CastroGerman/IDCI/Project Outputs for MyPro/BOM.xls

Comment | Description | Designator | Footprint | LibRef | Quantity
100nF 16V Y5R | Capacitor | C1, C2, C4, C6, C8, C10, C12, C14, C16, C18, C23, C33 | C_0805 | Capacitor | 12
10nF 16V Y5R | Capacitor | C3, C5, C7, C9, C11, C13, C15, C17, C19 | C_0805 | Capacitor | 9
18pF 16V C0G | Capacitor | C20, C21 | C_0805 | Capacitor | 2
10uF 16V Y5R | Capacitor | C22, C31 | C_0805 | Capacitor | 2
0.1uF 50V 10% | Capacitor | C24 | C_0805 | Capacitor | 1
47pF 50V C0G | Capacitor | C25, C26 | C_0805 | Capacitor | 2
10nF 16V N7R | Capacitor | C27 | C_0805 | Capacitor | 1
4.7uF 6.3V X5R | Capacitor | C28 | C_0805 | Capacitor | 1
100nF 16V X7R | Capacitor | C29, C30 | C_0805 | Capacitor | 2
220uF 6.3V 20% |  | C32 | CT_2917_D | Polarized Capacitor | 1
27nF 16V Y5R | Capacitor | C34 | C_0805 | Capacitor | 1
330pF 16V C0G | Capacitor | C35 | C_0805 | Capacitor | 1
BAT60J | Generic Diode | D1, D2 | SOD323 | Diode | 2
JTAG Header |  | J1 | HDRM_2.54MM_1X8 | JTAG Header | 1
JTAG Header_1 |  | J2, J4, J5, J6, J7 | HDRM_2.54MM_1X8 | JTAG Header_1, Connector1x8 | 5
USB MICRO AB |  | J3 | USB_MICRO_F_AB | Connectorx6 | 1
Connector |  | J8 | HDRM_0.1_1X4 | Connectorx4 | 1
Power Supply |  | J9 | HDRM_0.1_1X2 | Power Connector | 1
Green | Green LED | L1 | LED_0805 | Led_G | 1
Red | Red LED | L2 | LED_0805 | Led_R | 1
8.2uH 20% | Inductor | L3 | 1R5_1710 | Inductor | 1
TBJ |  | Q1, Q2 | SOT-23 | TBJ_NPN | 2
10KΩ 1% | Resistor | R1, R2, R3, R4, R5 | R_0805 | Resistor | 5
10K 5% | Resistor | R6, R12 | R_0805 | Resistor | 2
1K 5% | Resistor | R7, R9 | R_0805 | Resistor | 2
27R 5% | Resistor | R8, R10 | R_0805 | Resistor | 2
12K 1% | Resistor | R11, R13 | R_0805 | Resistor | 2
15K 5% | Resistor | R14 | R_0805 | Resistor | 1
470R 5% | Resistor | R15, R16 | R_0805 | Resistor | 2
9.1KΩ 1% | Resistor | R17 | R_0805 | Resistor | 1
5.49KΩ 1% | Resistor | R18 | R_0805 | Resistor | 1
3.6KΩ 1% | Resistor | R19 | R_0805 | Resistor | 1
TestPoint |  | TP0 | TestPoint | TestPoint | 1
LPC1769 | 32 bit ARM Cortex M3 | U1 | LQFP100 | LPC1769 | 1
ESP32WROOM |  | U2 | ESP32_WROOM - DUPLICATE | ESP32WROOM | 1
FT231XS | FT231XS | U3 | SSOP_20 | FT231XS | 1
A5972D | Fuente Switching 3.3v 1.5A | U4 | SO_8 | A5972D | 1
ABM8W 12MHz | Crystal | Y1 | ABM8W | Crystal | 1
