CastroGerman/IDCI/(list of files, drawings)

Other design files:
ESP32WROOM.SchDoc
LPC1769.SchDoc
MyPro.PcbDoc
MyPro.PcbLib
MyPro.PrjPCB
MyPro.SchLib
Panelizado.PcbDoc
Perifericos.SchDoc
