CastroGerman/IDCI/(commit log)

2019-07-16 No IPS, only JTAG
    Esquematico: Cableado de Uart's listo/r/n Cableado de GPIO's a la espera.
    [MyPro.PrjPCB, MyPro.SchLib, MyProSch1.SchDoc, MyProSch2.SchDoc, MyProSch3.SchDoc, MyProSch4.SchDoc, MyProSch5.SchDoc]
2019-07-19 Switching + Bridge Routing
    [MyPro.PcbDoc, MyPro.PcbLib, MyPro.PrjPCB, MyProSch1.SchDoc, MyProSch3.SchDoc, MyProSch4.SchDoc]
2019-07-19 Clean Branch
    [MyPro.PcbDoc, MyPro.PcbLib, MyPro.PrjPCB, MyPro.SchLib, MyProSch1.SchDoc, MyProSch3.SchDoc, MyProSch4.SchDoc]
2019-07-22 Primer routeo general
    NEW: LPC JTAG pull ups resistors. RTS & DTR pins on ISP Debug. SOT-23 footprint. LPC & ESP32 routing. DELETE: ESP JTAG serial resistors. PENDING: Power Lines routing (5v, 3.3v, GND). JTAG connectors routing. New components layout.
    [MyPro.PcbDoc, MyPro.PcbLib, MyPro.PrjPCB, MyPro.SchLib, MyProSch1.SchDoc, MyProSch3.SchDoc, MyProSch4.SchDoc]
2019-08-28 Board Update
    Nueva disposicion LPC JTAG y Switching
    [MyPro.PcbDoc, MyPro.PcbLib, MyPro.SchLib, MyProSch1.SchDoc, MyProSch3.SchDoc]
2019-09-06 Board Update: GPIOs routing
    [MyPro.PcbDoc]
2019-09-07 Commit de entrega (#5)
    [MyPro.PcbDoc, MyPro.PcbLib, MyPro.PrjPCB, MyPro.SchLib, MyProSch1.SchDoc, MyProSch3.SchDoc, MyProSch4.SchDoc]
2019-09-07 Commit entrega (#9)
    [MyPro.PcbDoc, MyPro.PrjPCB]
2019-09-15 Board Update
    Delete some Solder Masks
    [MyPro.PcbDoc, MyPro.PcbLib, MyPro.PrjPCB]
2019-09-23 Pre Entrega
    [ESP32WROOM.SchDoc, LPC1769.SchDoc, MyPro.PcbDoc, MyPro.PcbLib, MyPro.PrjPCB, MyProSch1.SchDoc, MyProSch3.SchDoc, MyProSch4.SchDoc]
2019-10-04 Commit Entrega v0
    [MyPro.PcbDoc, MyPro.PcbLib, MyPro.SchLib, Perifericos.SchDoc]
